SumairAmrala/esp32-rover/(commit log)

2026-05-07 Add all information about Rover to readme
    Including software + hardware features, wiring, and updates throughout versions 1.0, 1.1, and 2.0
2026-05-07 Change the connectionTimeout constant
    connectionTimeout was set to 2000ms for testing purposes. Switched back to 300ms to be accurate to the README
2026-05-08 Add more information to properly explain battery monitering for Rover v2.0
