SumairAmrala/esp32-rover/controllers.JPG

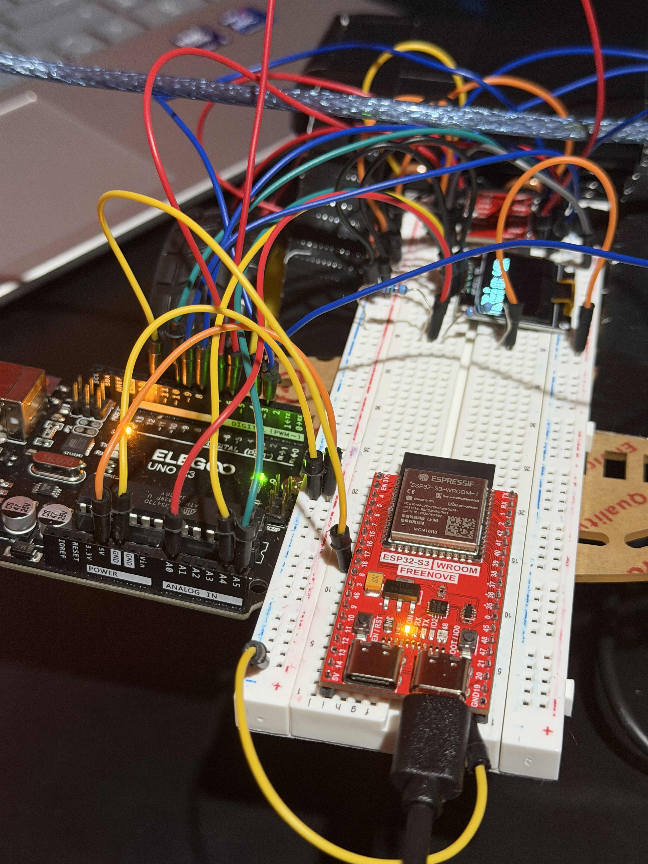
[picture p9: images/v1/controllers.JPG]
controllers.JPG
