SumairAmrala/esp32-rover/images/v1/wiring.JPG

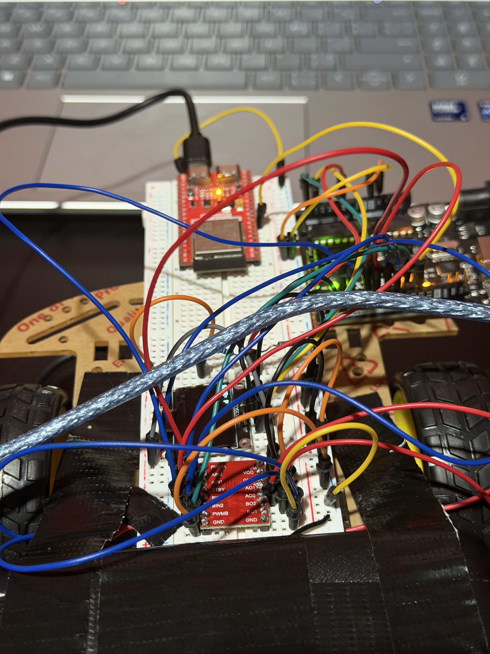
[picture p10: images/v1/wiring.JPG]
images/v1/wiring.JPG
