SumairAmrala/esp32-rover/chassis.JPG

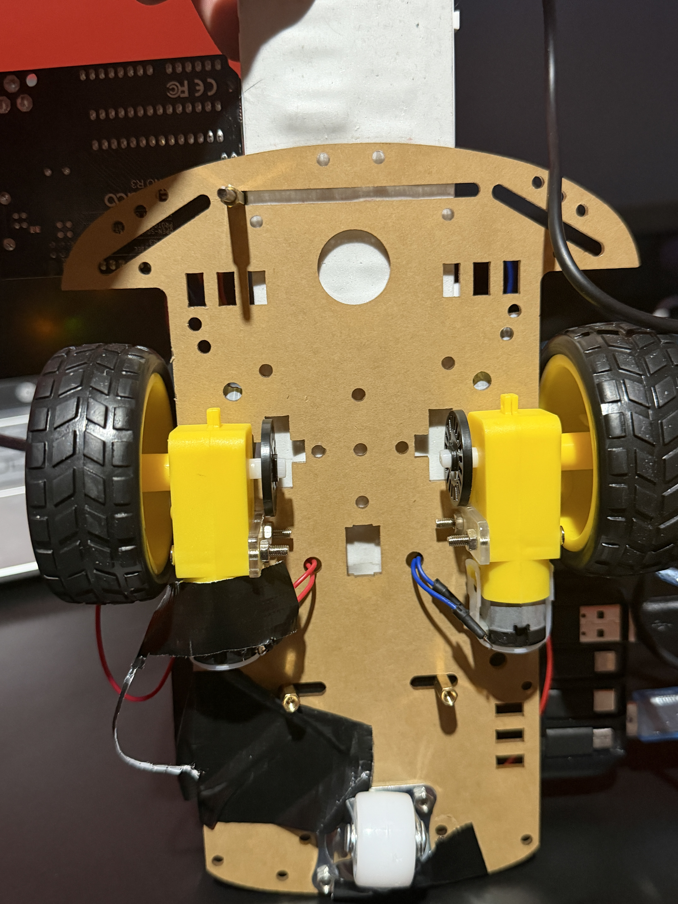
[picture p12: images/v1/chassis.JPG]
chassis.JPG
